SteveMayze/FieldDevice/doc/Spice/SelectiveDivider.asc

C1: cap; 100n
D1: diode; 1N4148
D2: zener; BZX84C8V2L
M1: pmos; FDC638P
Q1: npn; 2N3904
R1: res; 10k
R2: res; 1k
R3: res; 10k
R4: res; 47k
R5: res; 47k
V1: battery; PULSE(0 14.8 0.2 1 1 0.3 1 2)
V2: battery; PULSE(0.2 3.3 0.3 0.001 0.001 0.3 1 2)
Named nets: 0, Vout, MCU, BATT, Gate
.tran 0 2 0 0.01 startup
