SteveMayze/FieldDevice/kicad/FieldDevice.kicad_pcb

## KiCad design kicad/FieldDevice.kicad_pcb (2018-02-03)

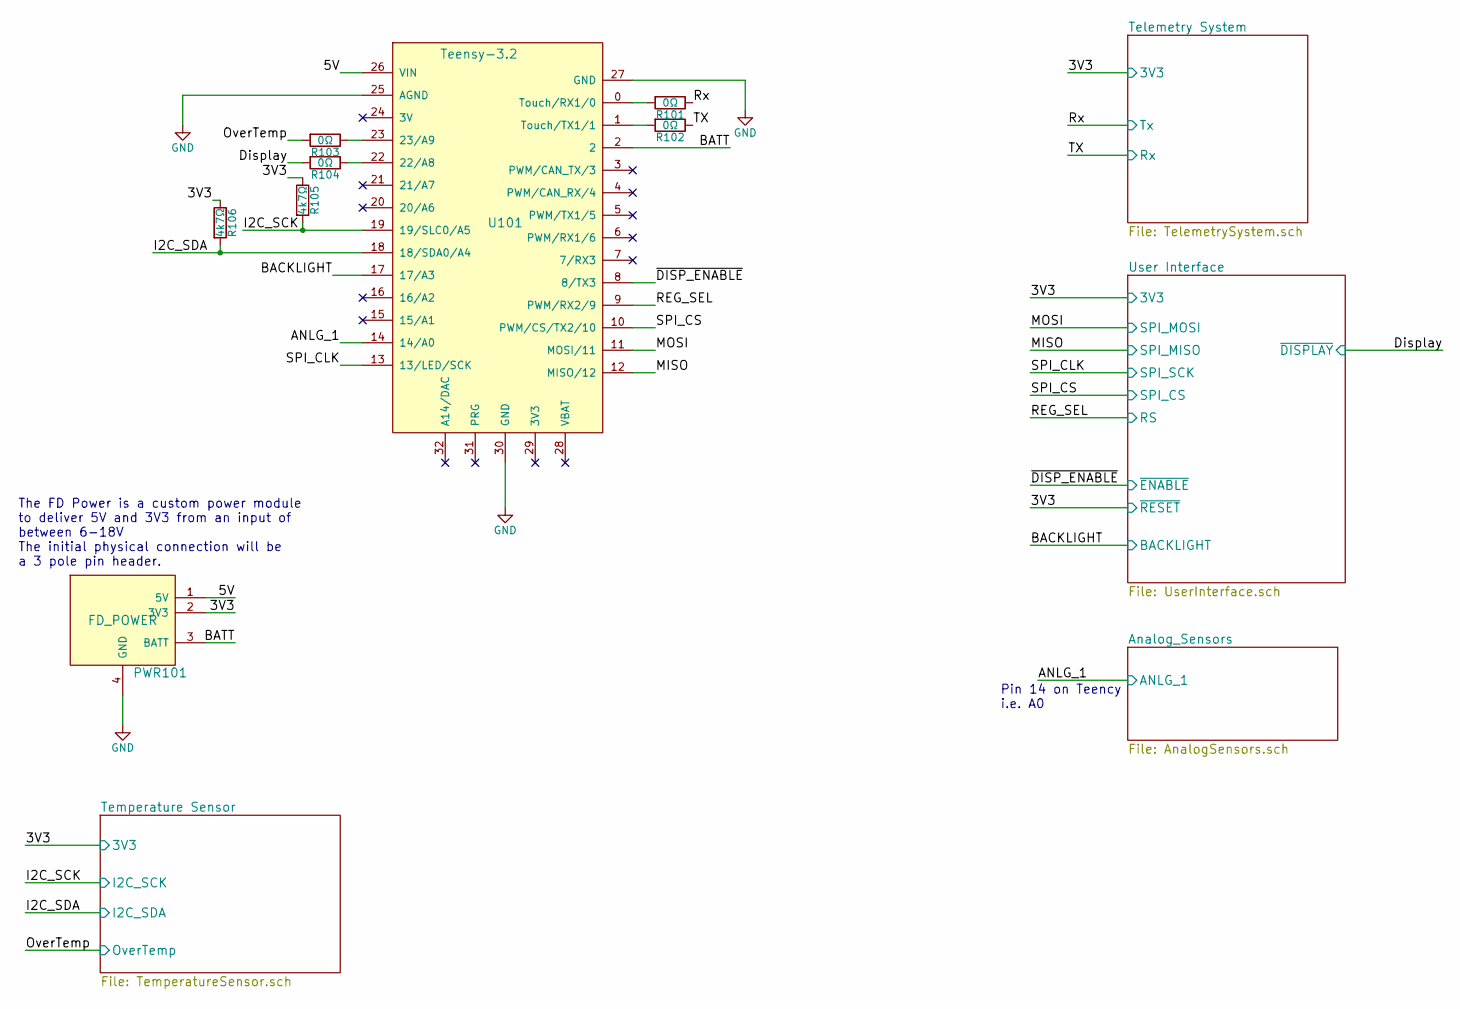
[picture p1: schematic FieldDevice.sch, Field Device - Battery Monitor]

Parts:
PWR101: FD_POWER; Pin_Header_Angled_1x04_Pitch2.54mm
R101, R102, R103, R104: 0Ω; R_0805
R105, R106: 4k7Ω; R_0805
U101: Teensy-3.2; Teensy-32

Connections:
/3V3: PWR101.2 (3V3), R105.1, R106.1; also elsewhere on the board
/5V: PWR101.1 (5V), U101.26 (VIN)
/ANLG_1: U101.14 (14/A0); also elsewhere on the board
/BACKLIGHT: U101.17 (17/A3); also elsewhere on the board
/BATT: PWR101.3 (BATT), U101.2
/Display: R104.2; also elsewhere on the board
/I2C_SCK: R105.2, U101.19 (19/SLC0/A5); also elsewhere on the board
/I2C_SDA: R106.2, U101.18 (18/SDA0/A4); also elsewhere on the board
/MISO: U101.12 (MISO/12); also elsewhere on the board
/MOSI: U101.11 (MOSI/11); also elsewhere on the board
/OverTemp: R103.2; also elsewhere on the board
/REG_SEL: U101.9 (PWM/RX2/9); also elsewhere on the board
/Rx: R101.1; also elsewhere on the board
/SPI_CLK: U101.13 (13/LED/SCK); also elsewhere on the board
/SPI_CS: U101.10 (PWM/CS/TX2/10); also elsewhere on the board
/TX: R102.1; also elsewhere on the board
/~DISP_ENABLE: U101.8 (8/TX3); also elsewhere on the board
GND: PWR101.4 (GND), U101.25 (AGND), U101.27 (GND), U101.30 (GND); also elsewhere on the board
unnamed: R101.2, U101.0 (Touch/RX1/0)
unnamed: R102.2, U101.1 (Touch/TX1/1)
unnamed: R103.1, U101.23 (23/A9)
unnamed: R104.1, U101.22 (22/A8)

Notes on the sheet:
Pin 14 on Teency i.e. A0
The FD Power is a custom power module to deliver 5V and 3V3 from an input of between 6-18V The initial physical connection will be a 3 pole pin header.

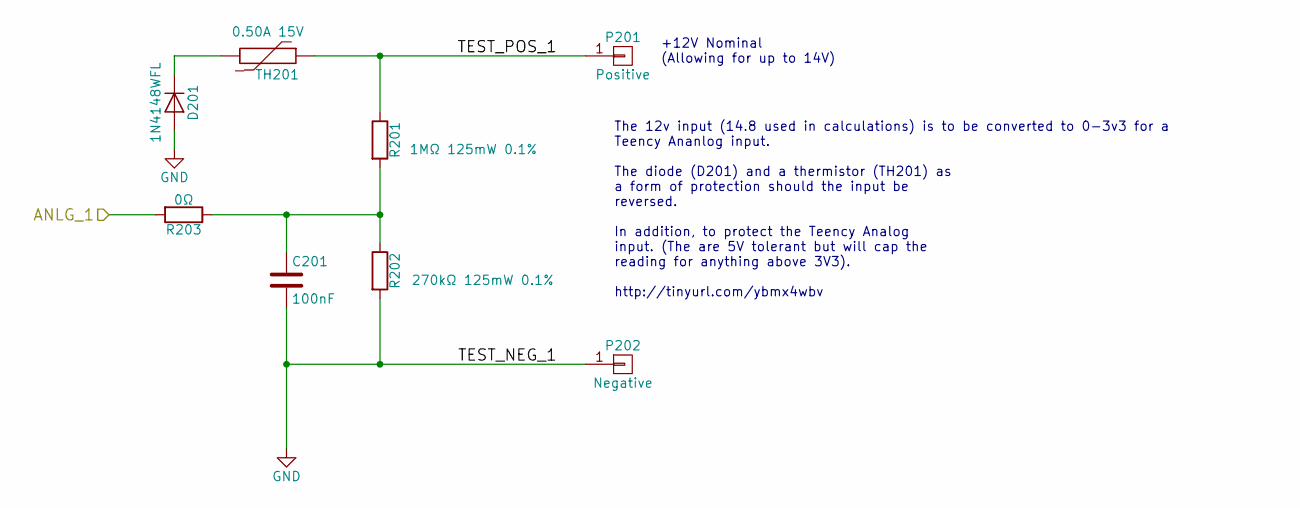
[picture p2: schematic AnalogSensors.sch]

Parts:
C201: 100nF; C_0805_HandSoldering
D201: 1N4148WFL; D_SOD-123; MPN 1N4148WFL-G3-08GICT-ND
P201: Positive; Pin_Header_Straight_1x01_Pitch2.54mm
P202: Negative; Pin_Header_Straight_1x01_Pitch2.54mm
R201: 1MΩ 125mW 0.1%; R_1206; MPN SPR-1206 100K
R202: 270kΩ 125mW 0.1%; R_1206; MPN SPR-1206 39,0K
R203: 0Ω; R_0805
TH201: 0.50A 15V; R_1812_HandSoldering; MPN MF-MSMF050-2

Connections:
/ANLG_1: R203.2; also elsewhere on the board
/Analog_Sensors/TEST_POS_1: P201.1, R201.1, TH201.1
GND: C201.2, D201.2 (A), P202.1, R202.2; also elsewhere on the board
unnamed: C201.1, R201.2, R202.1, R203.1
unnamed: D201.1 (K), TH201.2

Notes on the sheet:
+12V Nominal (Allowing for up to 14V)
The 12v input (14.8 used in calculations) is to be converted to 0-3v3 for a Teency Ananlog input. The diode (D201) and a thermistor (TH201) as a form of protection should the input be reversed. In addition, to protect the Teency Analog input. (The are 5V tolerant but will cap the reading for anythi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

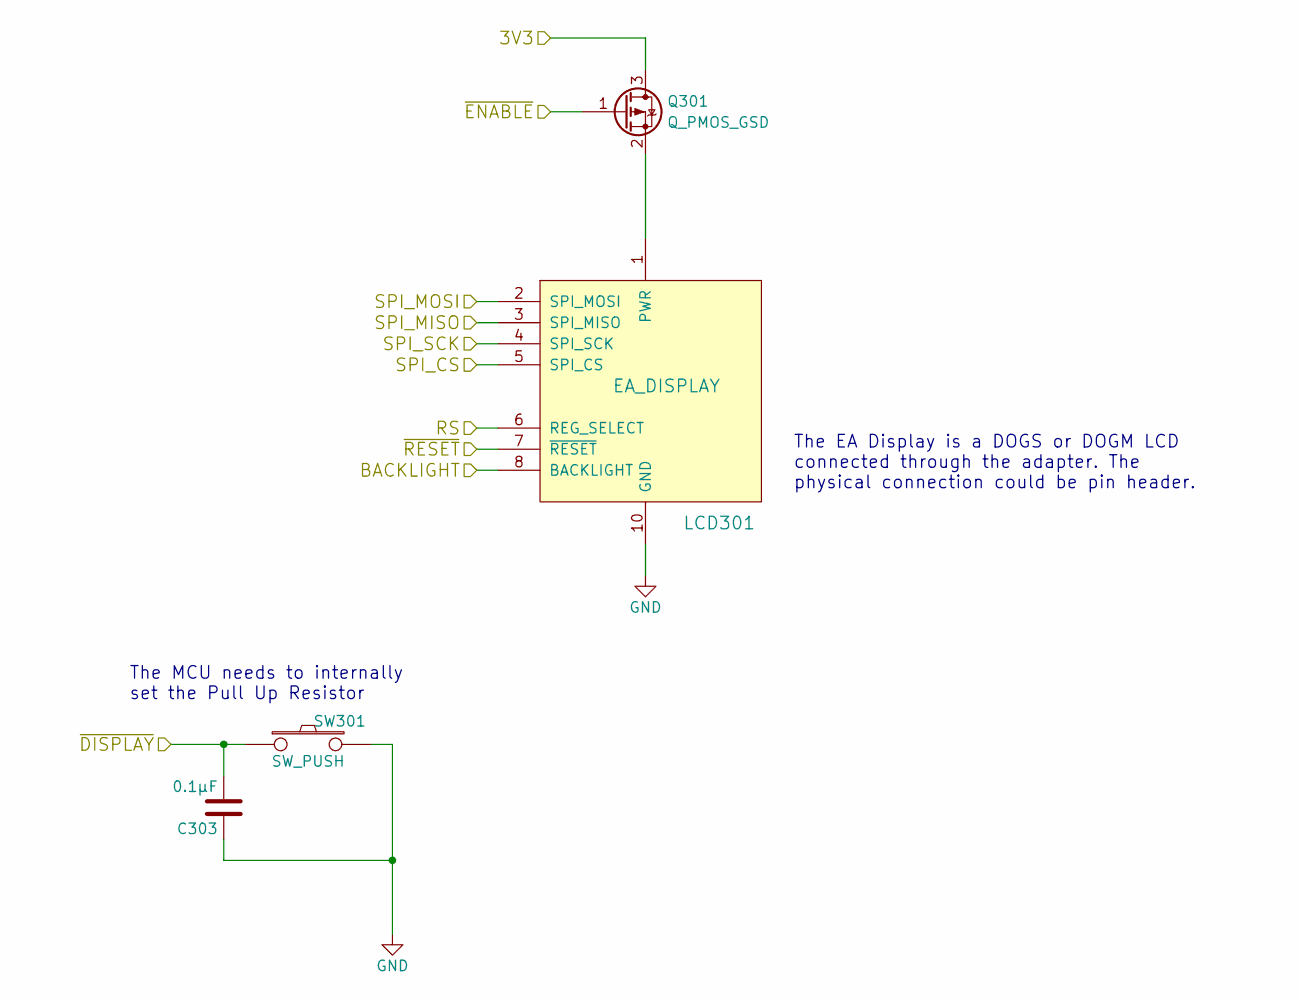
[picture p3: schematic UserInterface.sch]

Parts:
C303: 0.1μF; C_0805
LCD301: EA_DISPLAY; Pin_Header_Angled_1x10_Pitch2.54mm
Q301: Q_PMOS_GSD; SOT-23; MPN STR1P2UH7
SW301: SW_PUSH; Pin_Header_Straight_1x02_Pitch2.54mm

Connections:
/3V3: LCD301.7 (~RESET), Q301.3 (D); also elsewhere on the board
/BACKLIGHT: LCD301.8 (BACKLIGHT); also elsewhere on the board
/Display: C303.2, SW301.1; also elsewhere on the board
/MISO: LCD301.3 (SPI_MISO); also elsewhere on the board
/MOSI: LCD301.2 (SPI_MOSI); also elsewhere on the board
/REG_SEL: LCD301.6 (REG_SELECT); also elsewhere on the board
/SPI_CLK: LCD301.4 (SPI_SCK); also elsewhere on the board
/SPI_CS: LCD301.5 (SPI_CS); also elsewhere on the board
/~DISP_ENABLE: Q301.1 (G); also elsewhere on the board
GND: C303.1, LCD301.10 (GND), SW301.2; also elsewhere on the board
unnamed: LCD301.1 (PWR), Q301.2 (S)

Notes on the sheet:
The MCU needs to internally set the Pull Up Resistor
The EA Display is a DOGS or DOGM LCD connected through the adapter. The physical connection could be pin header.

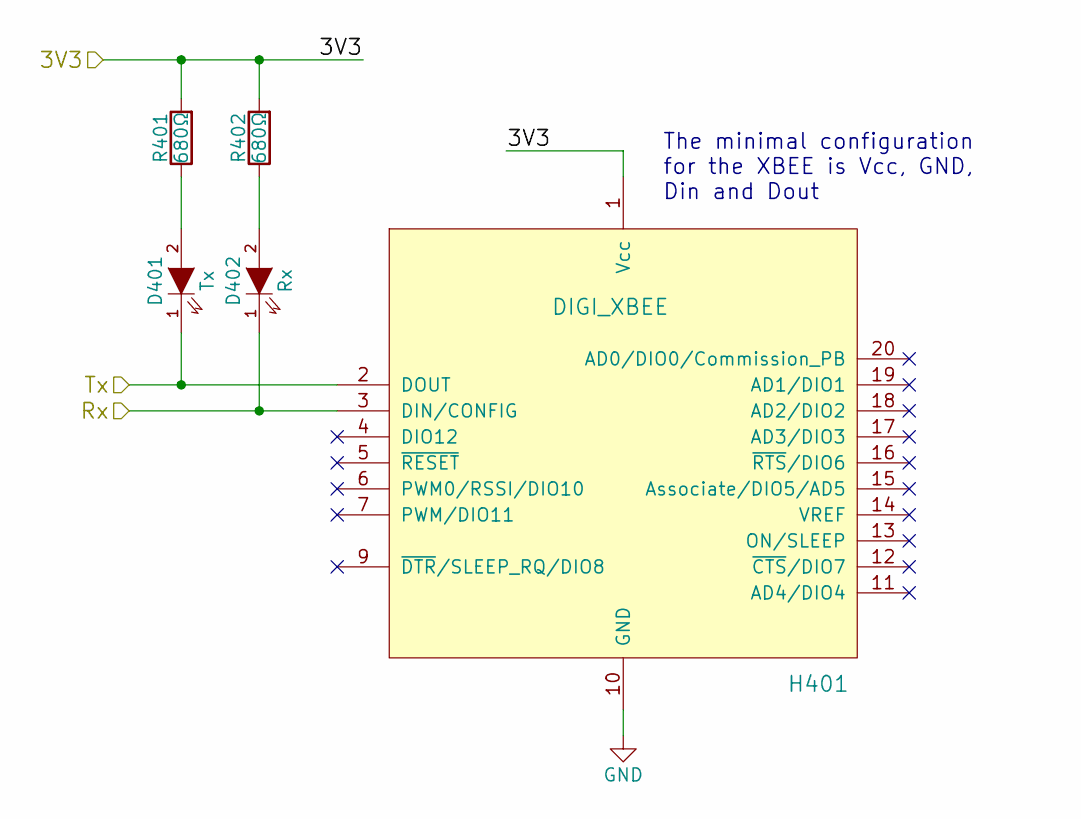
[picture p4: schematic TelemetrySystem.sch]

Parts:
D401: Tx; D_0805
D402: Rx; D_0805
H401: DIGI_XBEE; XBEE_S2C
R401, R402: 680Ω; R_0805

Connections:
/3V3: H401.1 (Vcc), R401.2, R402.2; also elsewhere on the board
/Rx: D401.1 (K), H401.2 (DOUT); also elsewhere on the board
/TX: D402.1 (K), H401.3 (DIN/CONFIG); also elsewhere on the board
GND: H401.10 (GND); also elsewhere on the board
unnamed: D401.2 (A), R401.1
unnamed: D402.2 (A), R402.1

Notes on the sheet:
The minimal configuration for the XBEE is Vcc, GND, Din and Dout

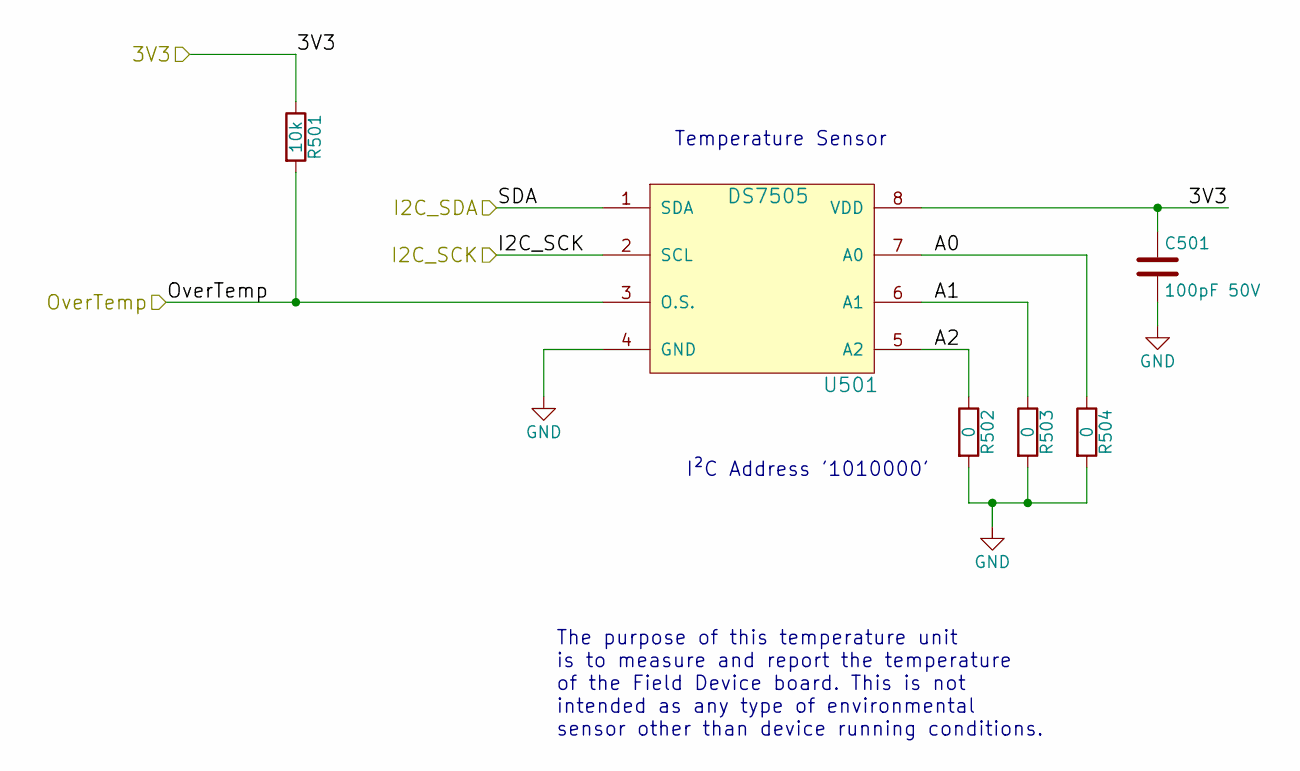
[picture p5: schematic TemperatureSensor.sch]

Parts:
C501: 100pF 50V; C_0805
R501: 10k; R_0805
R502, R503, R504: 0; R_0805
U501: DS7505; SOIC-8_3.9x4.9mm_Pitch1.27mm

Connections:
/3V3: C501.1, R501.1, U501.8 (VDD); also elsewhere on the board
/I2C_SCK: U501.2 (SCL); also elsewhere on the board
/I2C_SDA: U501.1 (SDA); also elsewhere on the board
/OverTemp: R501.2, U501.3 (O.S.); also elsewhere on the board
/Temperature Sensor/A0: R504.1, U501.7 (A0)
/Temperature Sensor/A1: R503.1, U501.6 (A1)
/Temperature Sensor/A2: R502.1, U501.5 (A2)
GND: C501.2, R502.2, R503.2, R504.2, U501.4 (GND); also elsewhere on the board

Notes on the sheet:
Temperature Sensor
I²C Address '1010000'
The purpose of this temperature unit is to measure and report the temperature of the Field Device board. This is not intended as any type of environmental sensor other than device running conditions.

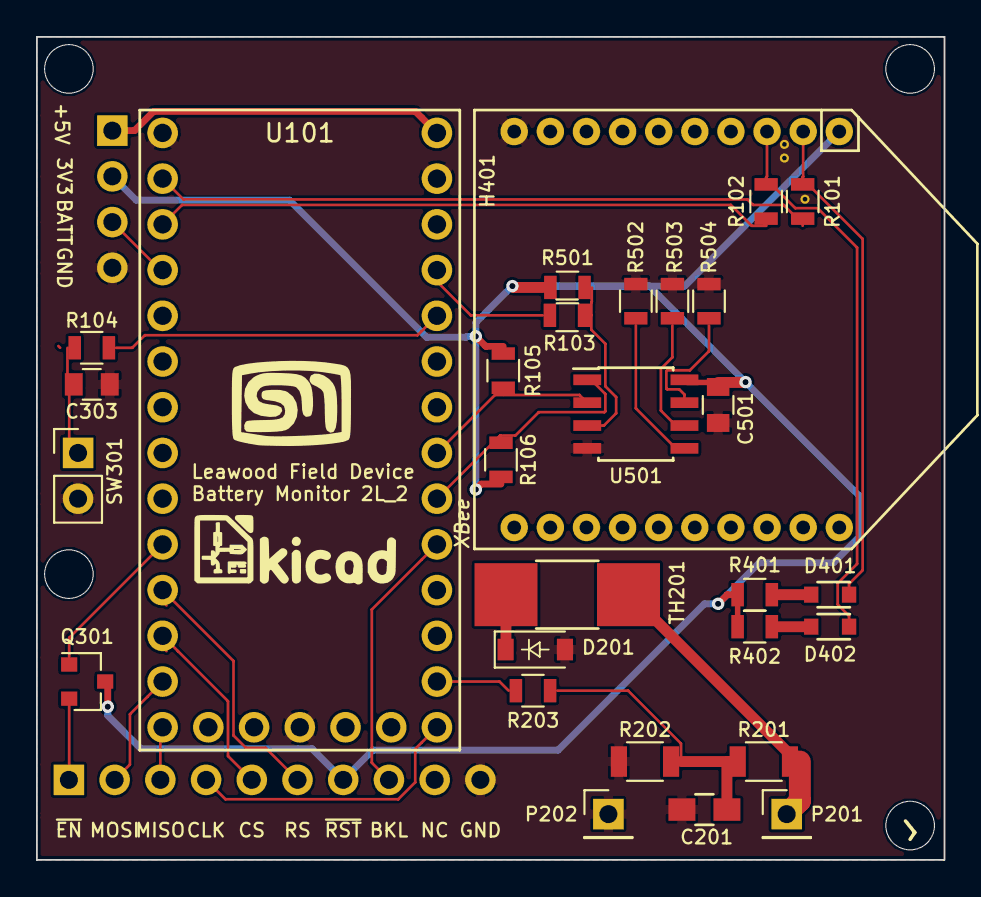
[picture p6: board FieldDevice.kicad_pcb from above]

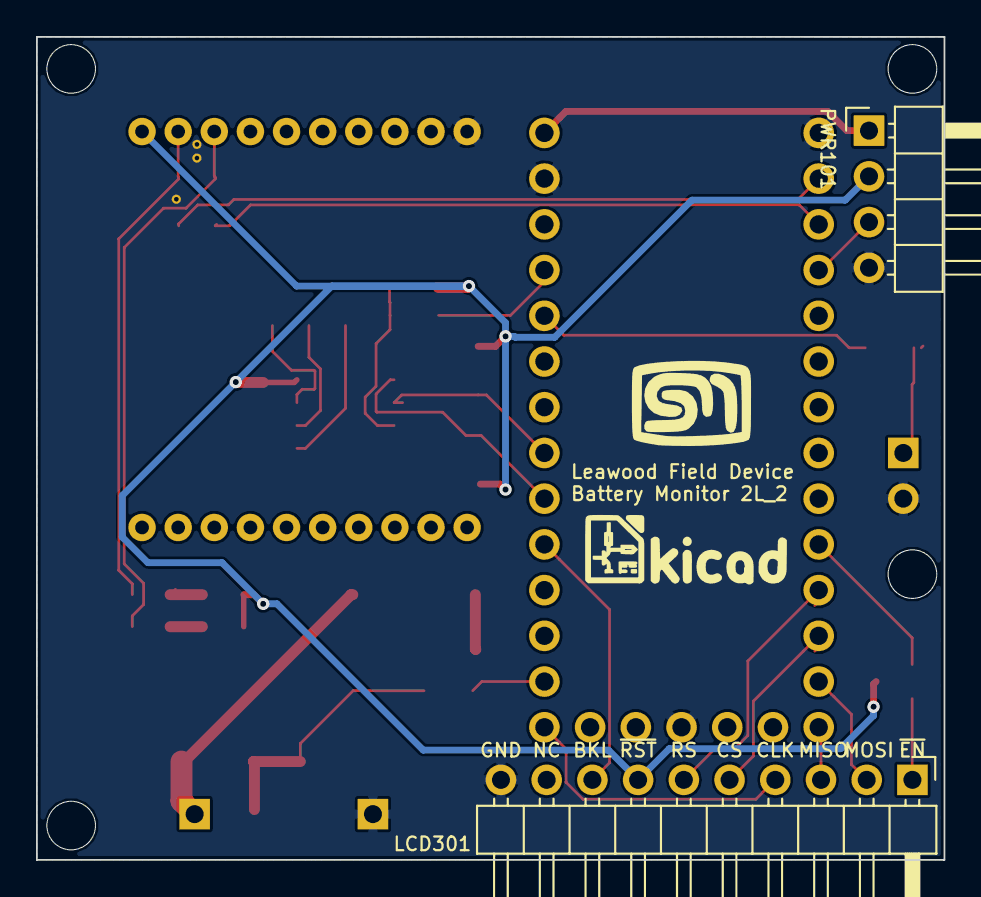
[picture p7: board FieldDevice.kicad_pcb from below]

Board: 2 copper layers, 50.4 x 45.7 mm, 34 parts (2 on the bottom side), 31 nets.

Other parts of the board:
ST**: STITCH_VIA
ST**#2, ST**#3: STITCH_VIA

Their connections:
GND: ST**.1, ST**#2.1, ST**#3.1; also elsewhere on the board
