SteveMayze/FieldDevice/doc/VoltageTesterConversion.ods

Vs | Vt | ADC
0 |  | 1
1 | 0.276 | 86
2 | 0.554 | 173
3 | 0.832 | 260
4 | 1.108 | 346
5 | 1.386 | 433
6 | 1.578 | 519
7 | 1.945 | 607
8 | 2.222 | 693
9 | 2.502 | 781
10 | 2.779 | 867
11 | 3.056 | 954
12 | 3.335 | 1023
13 | 3.612 | 1023
14 | 3.892 | 1023
 |  | 0.0032600196 | 0.0117302053
 |  | ADC | Vs
 |  | 0 | 0.0
 |  | 84 | 1.0
 |  | 168 | 2.0
 |  | 252 | 3.0
 |  | 336 | 3.9
 |  | 420 | 4.9
 |  | 504 | 5.9
 |  | 588 | 6.9
 |  | 672 | 7.9
 |  | 756 | 8.9
 |  | 840 | 9.9
 |  | 924 | 10.8
 |  | 1008 | 11.8
 |  | 1092 | 12.8
