SteveMayze/FieldDevice/doc/VoltageTesterConversion_2.ods

Vin | 9
R1 | 1000000
Vout | 3 | 3
R2 | 500000
 | 500000
I | 0.000006
