SteveMayze/FieldDevice/firmware/test/XBEE_2/XBee_2_Receive/XBee_2_Receive.ino

// DS7505 
// by Alexandre Coffignal <http://www. ... .com>

// Demonstrates use of the DS7505 library
// Reads data from an I2C/TWI DS7505 slave device

// Created 26 October 2010

#include <XBee.h>
#include <Wire.h>
#include <math.h>

#define VOLTAGE_SENSE 14
#define ADC_VOLTAGE 0.0117302053
#define nss Serial


double voltage_level = 0;

XBee xbee = XBee();
Rx64Response rx_response = Rx64Response();
// XBeeAddress64 target_addr = XBeeAddress64(0x0013A200, 0x41629BCE);
// TxStatusResponse txStatus = TxStatusResponse();

void setup()
{
  Wire.begin();        // join i2c bus (address optional for master)
  
  nss.begin(9600);  // start serial for output
  Serial1.begin(9600);
  xbee.setSerial(Serial1);
  
  voltage_level = analogRead( VOLTAGE_SENSE );

}


double to_temp(char exponent, char mantissa){
    double result = 0.0f;
    double _exponent = 0.0f;
    double _significad = 0.0f;

    // char _exp = exponent;
    _exponent = exponent;
    //for(int idx = 0; idx < 8; idx++){
    //    int bit = (_exp & (1<<idx))>>idx;        
    //    _exponent += bit * pow(2, idx);
    //}
    char _mantissa = mantissa;
    for(int idx= 0; idx < 8; idx++){
        int bit = (_mantissa & (1 << (7-idx))) >> (7-idx);
        _significad += bit * pow(2, (-1 *(idx+1)));
    }
    result = _exponent + _significad;
    return result;
}


void loop()
{

    xbee.readPacket();

  if (xbee.getResponse().isAvailable()) {
    // got something

    if (xbee.getResponse().getApiId() == ZB_RX_RESPONSE) {
      xbee.getResponse().getRx64Response(rx_response);

      nss.print("Received I/O Sample from: ");
      
      nss.print(rx_response.getRemoteAddress64().getMsb(), HEX);  
      nss.print(rx_response.getRemoteAddress64().getLsb(), HEX);  
      nss.println("");

      uint8_t* data = rx_response.getData();
      uint8_t str[100];
      for( int i=0; i<rx_response.getDataLength(); i++){
        str[i] = data[i+1];
      }
      str[rx_response.getDataLength()] = 0;

      nss.printf("{data: %s}", str);

      // method for printing the entire frame data
      //for (int i = 0; i < xbee.getResponse().getFrameDataLength(); i++) {
      //  nss.print(xbee.getResponse().getFrameData()[i], HEX);
      //  nss.print(" ");
      //}
      //nss.println("");
    } 
    else {
      nss.print("Expected I/O Sample, but got ");
      nss.print(xbee.getResponse().getApiId(), HEX);
    }    
  } else if (xbee.getResponse().isError()) {
    nss.print("Error reading packet.  Error code: ");  
    nss.println(xbee.getResponse().getErrorCode());
  }

  
  int sample_level = analogRead( VOLTAGE_SENSE );
  voltage_level = (double)sample_level * ADC_VOLTAGE;
  
  
  double temperature = 0;
  Wire.beginTransmission(0x48);
  Wire.write(0x00);
  Wire.endTransmission();
  
  Wire.requestFrom(0x48, 2);
  char temp_exp = 0;
  char temp_mant = 0;
  if( 2<= Wire.available()){
    temp_exp = Wire.read();
    temp_mant = Wire.read();
    temperature = to_temp(temp_exp, temp_mant);
  }

  
   nss.printf( "\nvoltage:{sample: %d, value: %f}, temperature:{sample:{%d, %d}, TEMPERATURE=%f}\n",
                sample_level, voltage_level, temp_exp, temp_mant, temperature );
//  sprintf(message, "\nvoltage:{sample: %d, value: %f}, temperature:{sample:{%d, %d}, TEMPERATURE=%f}\n",
//                sample_level, voltage_level, temp_exp, temp_mant, temperature );


    
  delay(5000);

}
