SteveMayze/FieldDevice/(commit log)

2017-06-04 Created the KiCad project for the first field module
    [FieldDevice.kicad_pcb, FieldDevice.sch]
2017-06-05 Adding more features to the design
    [FieldDevice.sch]
2017-06-13 Completed schematic, layout and gerbers. 2L_1
    [AnalogSensors.sch, Display.sch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]
2017-07-06 added the missing pullup resistors 2L_2
    [AnalogSensors.sch, Display.sch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]
2017-08-03 Corrected the usage of the CE_Header to be front-side only
    [AnalogSensors.sch, FieldDevice.kicad_pcb]
2017-08-09 Change over to use the DOGM081 adapter board rather than direct connect - also used the CE_Socket!
    [Display.sch, FieldDevice.kicad_pcb, FieldDevice.sch]
2017-08-13 Testing the idea of a zenner on the V Input. Added test code for the voltage test
    [AnalogSensors.sch, FieldDevice.sch]
2017-08-13 Created a small spreadsheet to record the voltage tester results
    [VoltageTesterConversion.ods]
2017-08-15 Some changes to the test firmware and removed the Zenner
    [AnalogSensors.sch]
2017-08-19 Small formatting changes on schematic for Forum questions
    [AnalogSensors.sch, VoltageTesterConversion_2.ods]
2017-10-05 Enhanced display port connector and layout - Submit to OSH Park
    [AnalogSensors.sch, Display.sch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]
2017-10-19 Added test code to drive the LCD display
    [AnalogSensors.sch, VoltageTesterConversion_2.ods]
2018-01-06 Started to implement the driver for the DOGS104 display
2018-01-08 Working on the DOGS104 display driver
2018-01-10 Reshuffled the firmware to keep the dogs081 driver
2018-01-10 Started to clean up the drivers for the respective displays
2018-01-10 Altered the display connector for the DOG104 i.e. general purpose
    [AnalogSensors.sch, Display.sch, FieldDevice.kicad_pcb, FieldDevice.sch]
2018-01-28 Revamping the schematic and layout for a deployable model
    [Display.sch, FieldDevice.sch]
2018-01-28 Added a driver for the DOGS104 Display
2018-01-30 Reworking the schematic
    [AnalogSensors.sch, Display.sch, FieldDevice.sch, PowerSystem.sch, TelemetrySystem.sch, TemperatureSensor.sch, UserInterface.sch]
2018-02-01 Completed the new schematic (draft) and started the layout to verify the design
    [AnalogSensors.sch, FieldDevice.kicad_pcb, FieldDevice.sch, PowerSystem.sch, TelemetrySystem.sch, TemperatureSensor.sch, UserInterface.sch]
2018-02-03 Completed the draft of REV2
    [AnalogSensors.sch, FieldDevice.kicad_pcb, FieldDevice.sch, TelemetrySystem.sch, TemperatureSensor.sch, UserInterface.sch]
2018-02-03 More changes to the layout for the Power System integration
    [AnalogSensors.sch, FieldDevice.kicad_pcb, FieldDevice.sch, TelemetrySystem.sch, TemperatureSensor.sch, UserInterface.sch]
2018-02-03 Removing the 3d model for the teensy
2018-02-26 Reduced the number of sends by testing changes in the Voltage only
2018-03-10 Added the attitional analog input for backup battery monitor - TBC
